OptimoSupreme/reactor/docs/images/layout-study-cpu-side.png

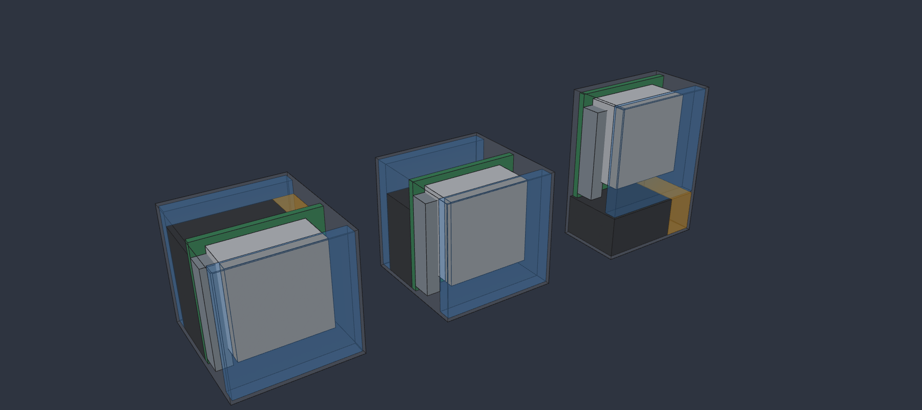
docs/images/layout-study-cpu-side.png
