OptimoSupreme/reactor/docs/images/layout-study-psu-side.png

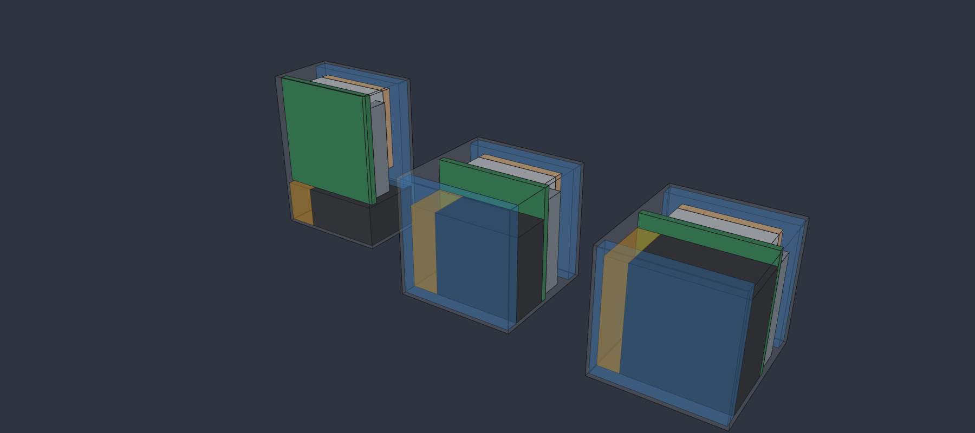
docs/images/layout-study-psu-side.png
