OptimoSupreme/reactor/docs/images/mk1-board-rear.png

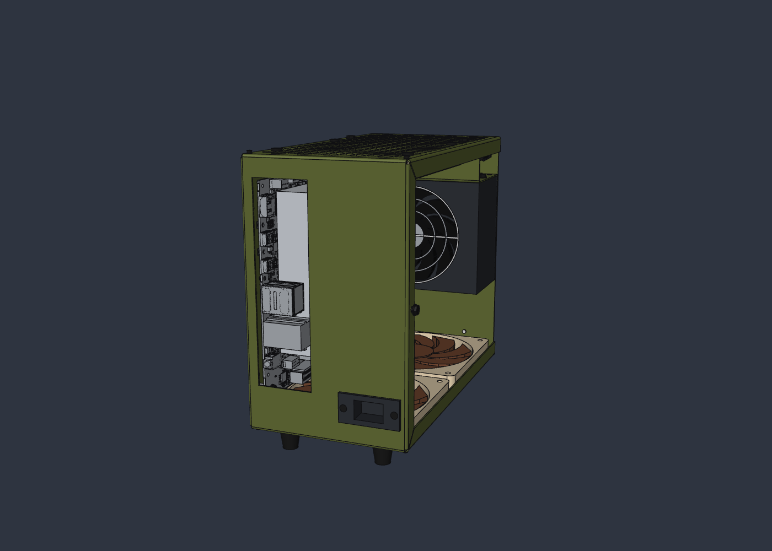
docs/images/mk1-board-rear.png
