OptimoSupreme/reactor/docs/images/mk1-foot.png

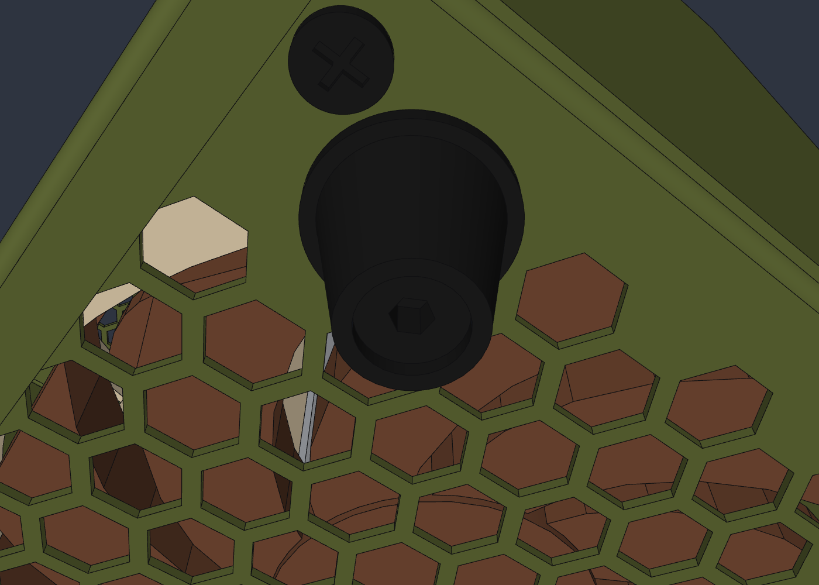
docs/images/mk1-foot.png
