OptimoSupreme/reactor/docs/images/mk1-open-board-side.png

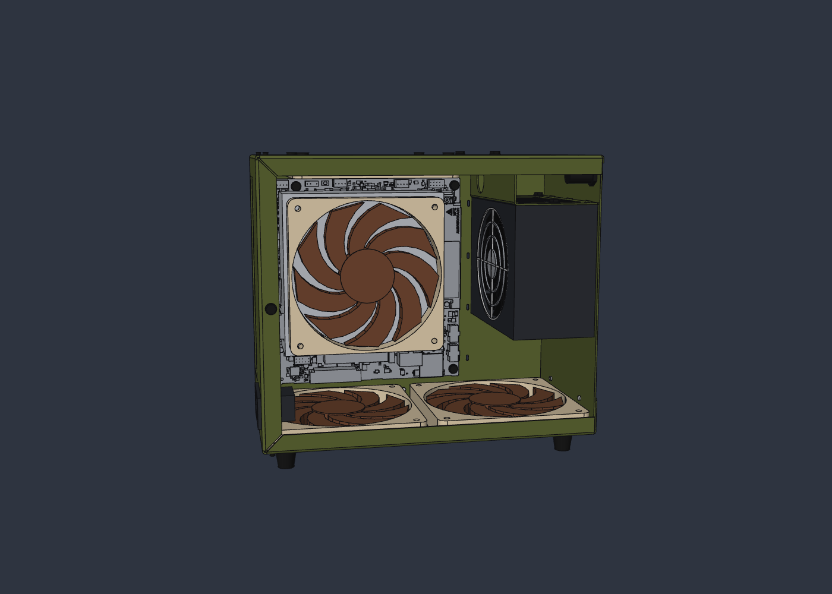
docs/images/mk1-open-board-side.png
