OptimoSupreme/reactor/docs/images/mk1-open-front.png

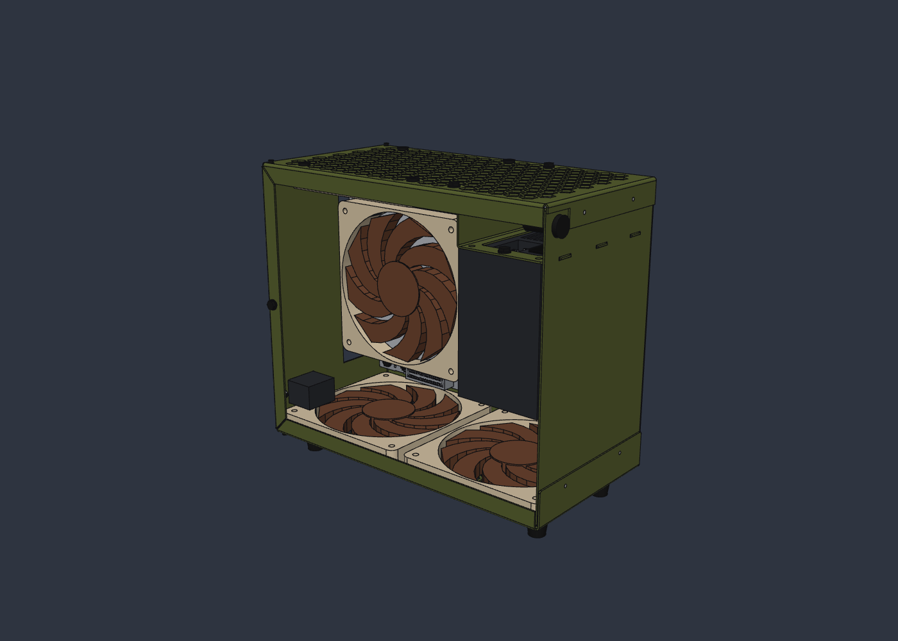
docs/images/mk1-open-front.png
