OptimoSupreme/reactor/docs/images/mk1-psu-mount.png

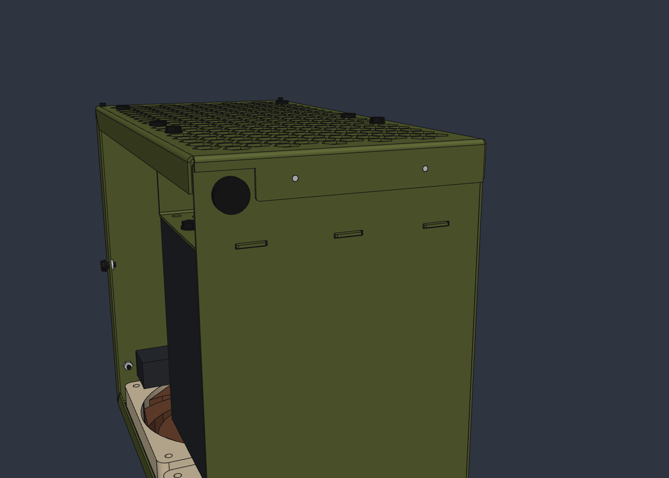
docs/images/mk1-psu-mount.png
