OptimoSupreme/reactor/docs/images/mk1-rear-corner.png

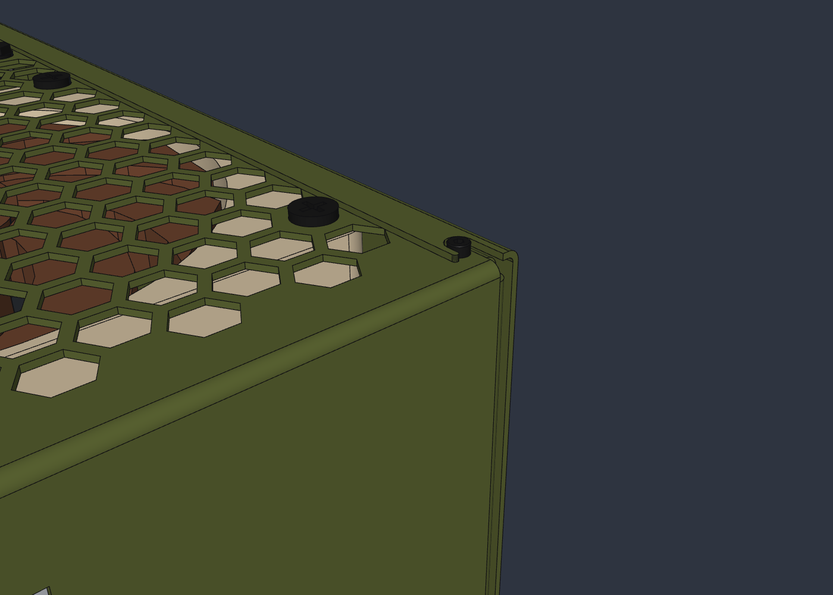
docs/images/mk1-rear-corner.png
