OptimoSupreme/reactor/docs/images/mk1-shelf-alone.png

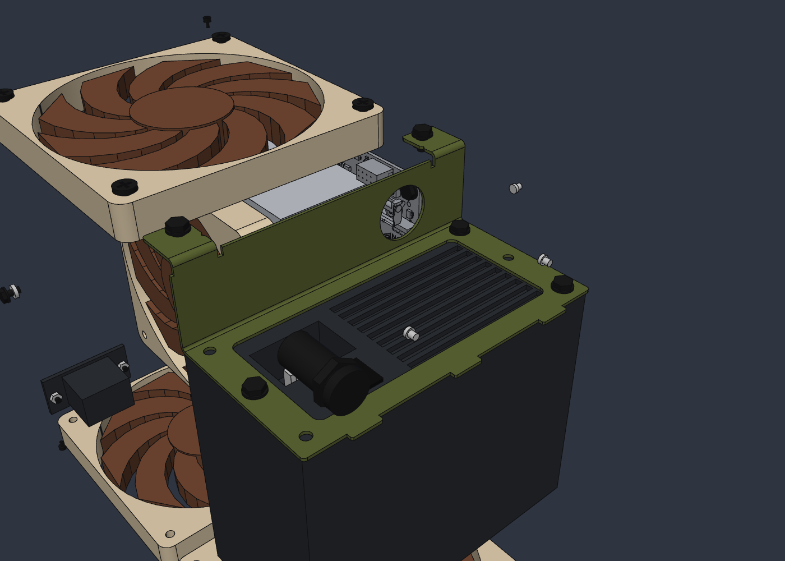
docs/images/mk1-shelf-alone.png
