OptimoSupreme/reactor/docs/images/mk1-shelf-tongues.png

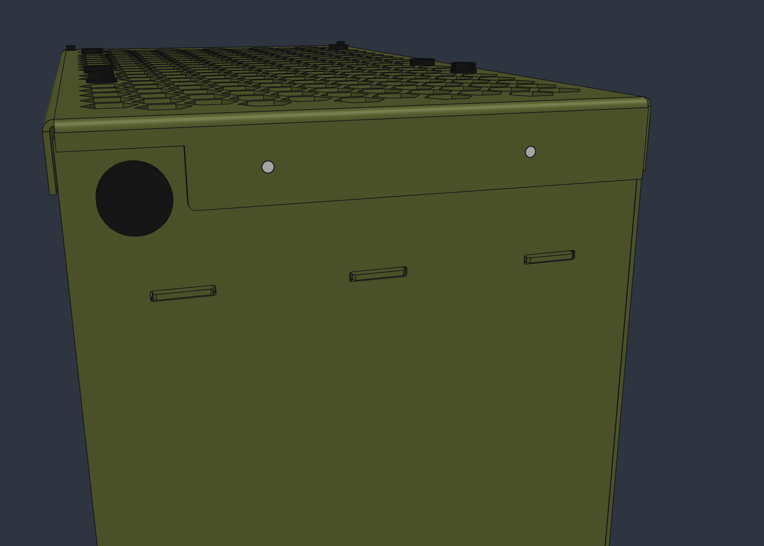
docs/images/mk1-shelf-tongues.png
