OptimoSupreme/reactor/docs/images/mk1-shelf-top.png

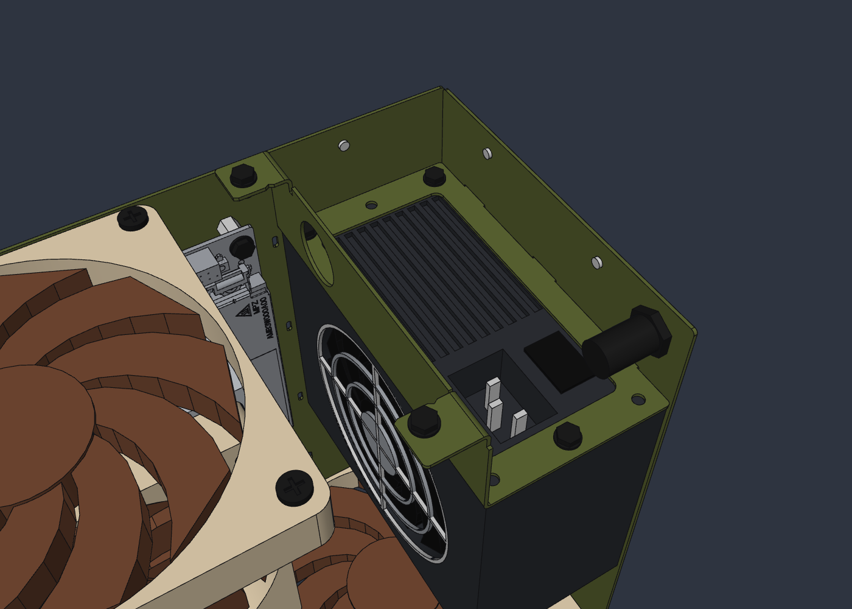
docs/images/mk1-shelf-top.png
