OptimoSupreme/reactor/docs/images/mk1-shell-screw-inside.png

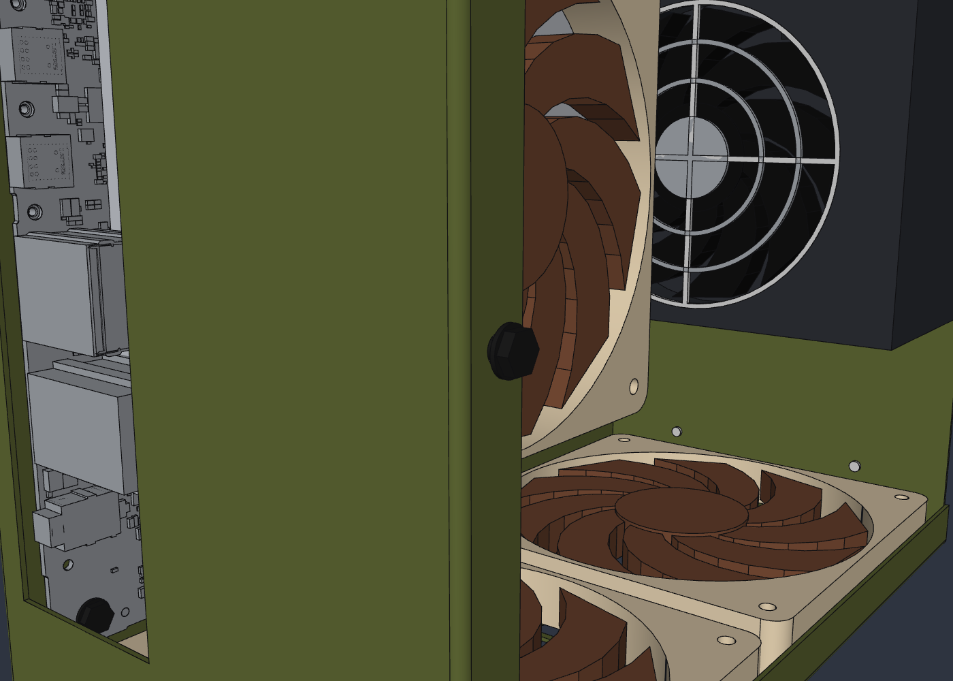
docs/images/mk1-shell-screw-inside.png
