OptimoSupreme/reactor/docs/images/mk1-switch-front.png

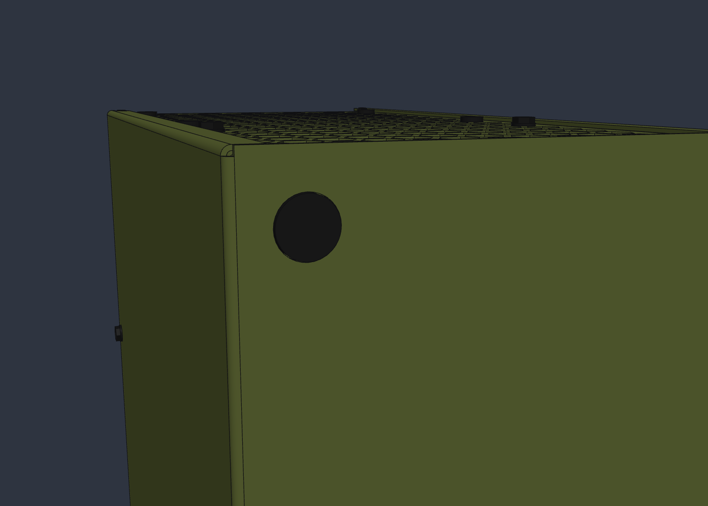
docs/images/mk1-switch-front.png
