OptimoSupreme/reactor/docs/images/mk1-switch-inside.png

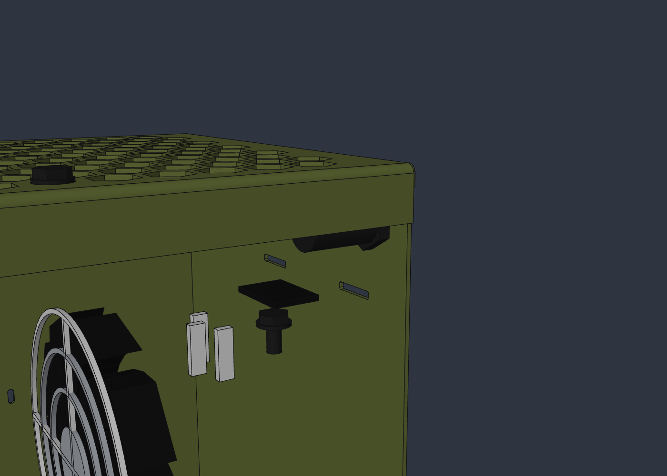
docs/images/mk1-switch-inside.png
