OptimoSupreme/reactor/docs/images/mk1-tie-slots.png

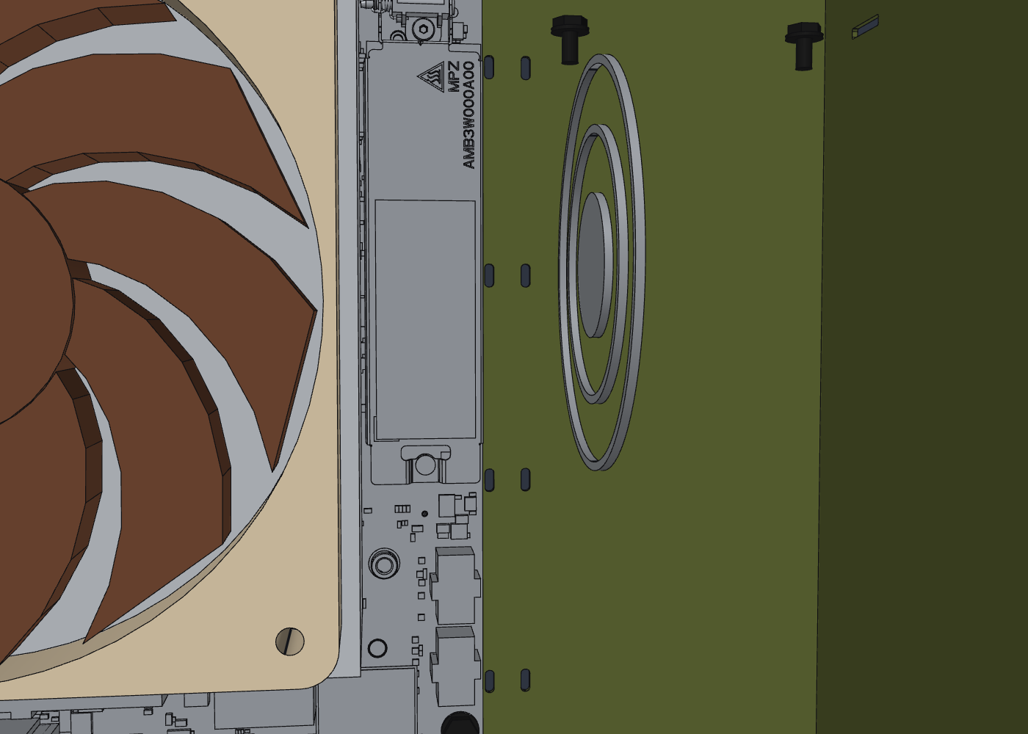
docs/images/mk1-tie-slots.png
