OptimoSupreme/reactor/docs/images/mk1-top-detail.png

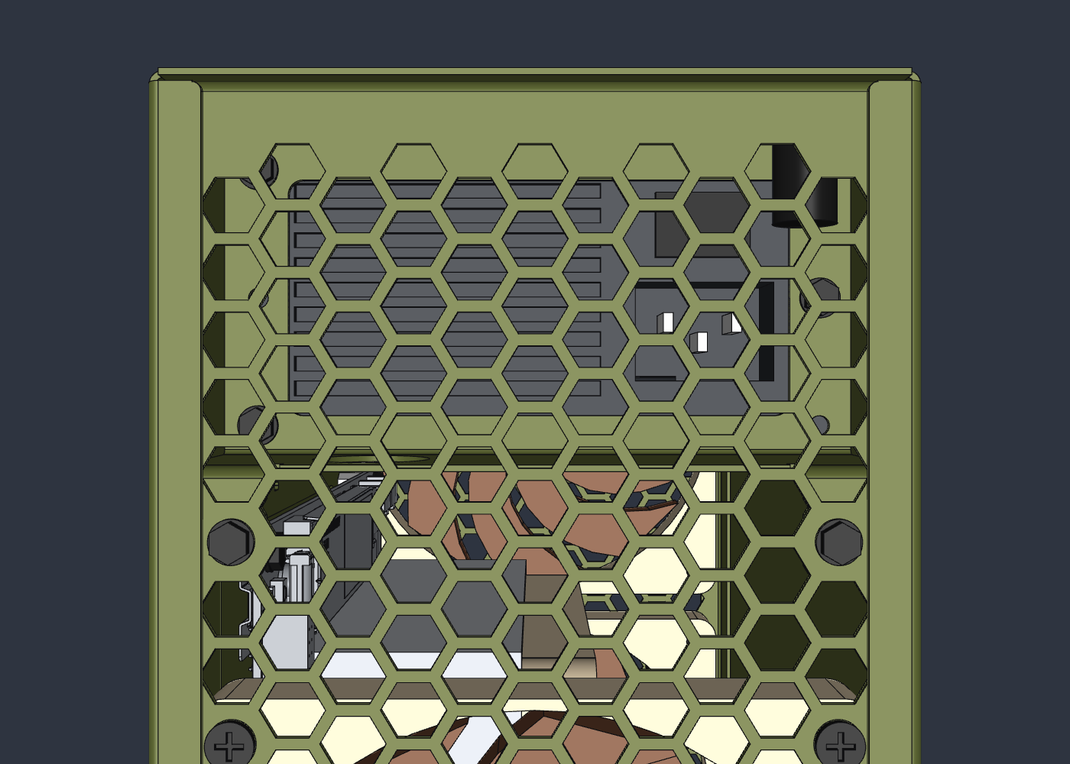
docs/images/mk1-top-detail.png
