OptimoSupreme/reactor/docs/images/mk1-top-plan.png

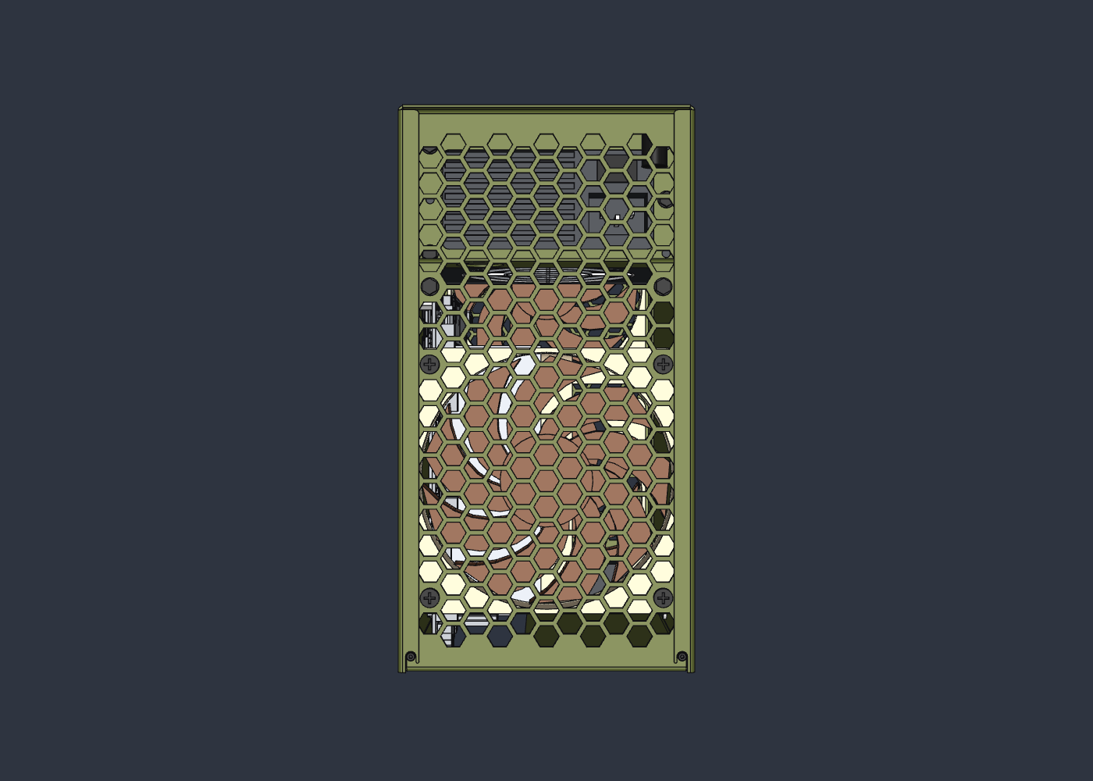
docs/images/mk1-top-plan.png
