OptimoSupreme/reactor/docs/images/mk1-top.png

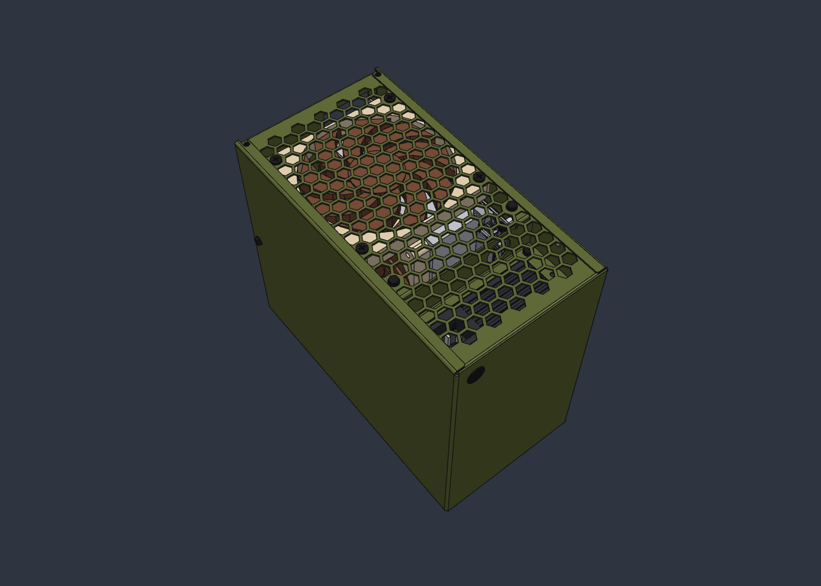
docs/images/mk1-top.png
