OptimoSupreme/reactor/docs/images/mk1-tray-side.png

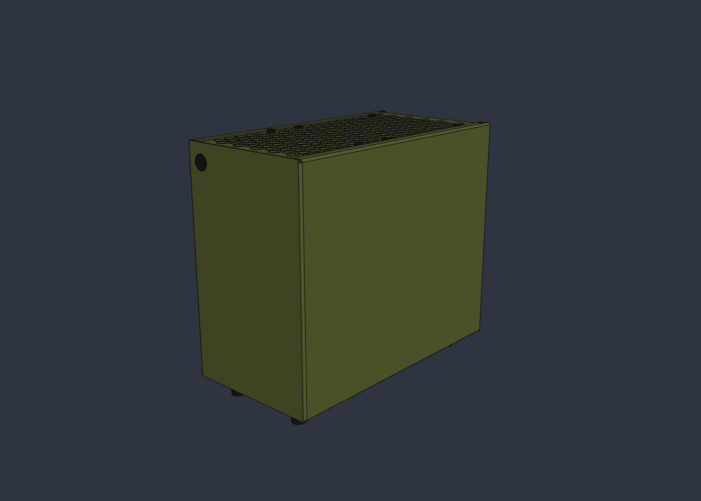
docs/images/mk1-tray-side.png
