OptimoSupreme/reactor/docs/images/mk1-under-corner.png

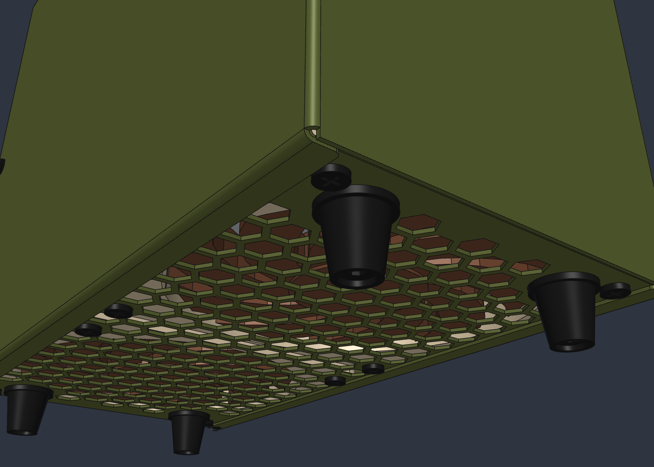
docs/images/mk1-under-corner.png
