OptimoSupreme/reactor/docs/images/mk1-under-plan.png

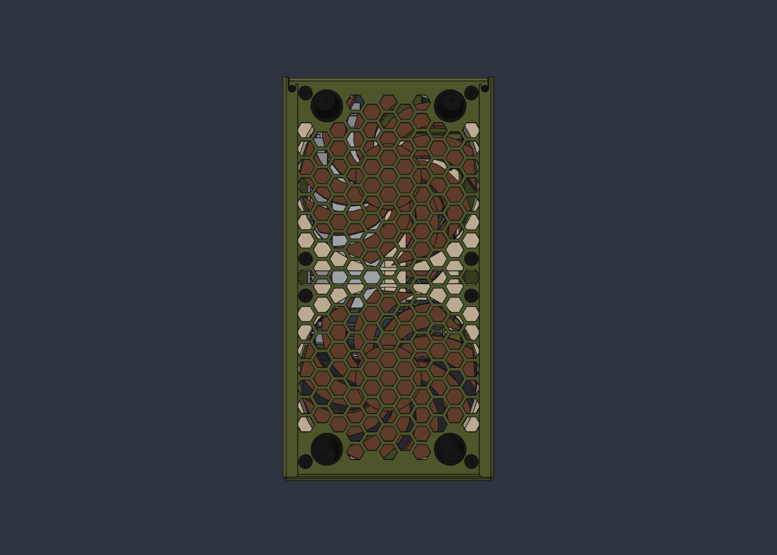
docs/images/mk1-under-plan.png
