OptimoSupreme/reactor/docs/images/mk1-under.png

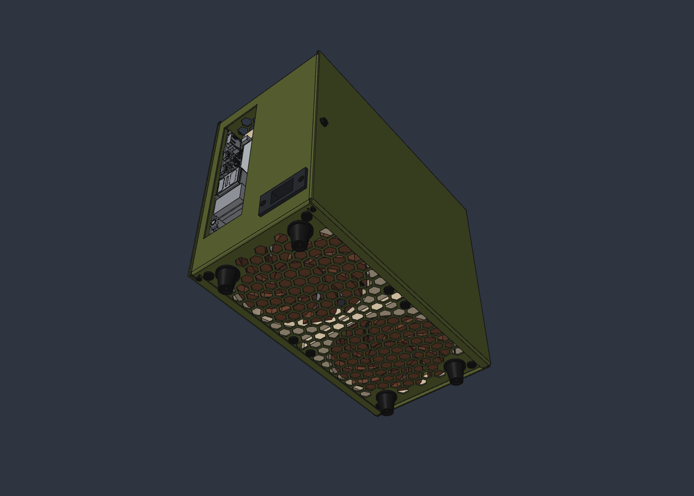
docs/images/mk1-under.png
