OptimoSupreme/reactor/mechanical/export/shell.step

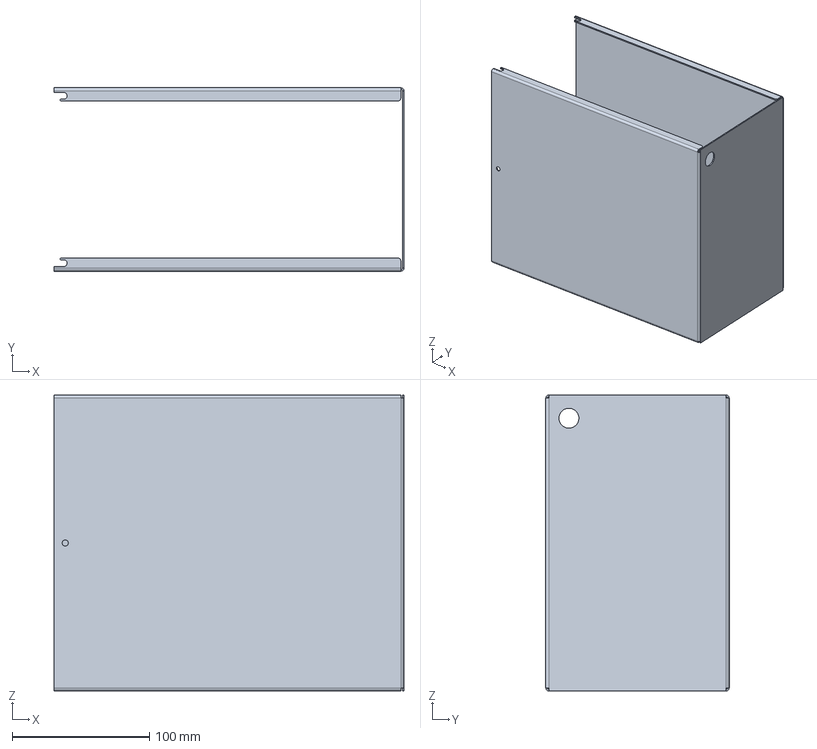
[picture p29: CAD file, 2026-11-13]
mechanical/export/shell.step
255.2 x 133.8 x 215.8 mm
