OptimoSupreme/reactor/mechanical/export/core.step

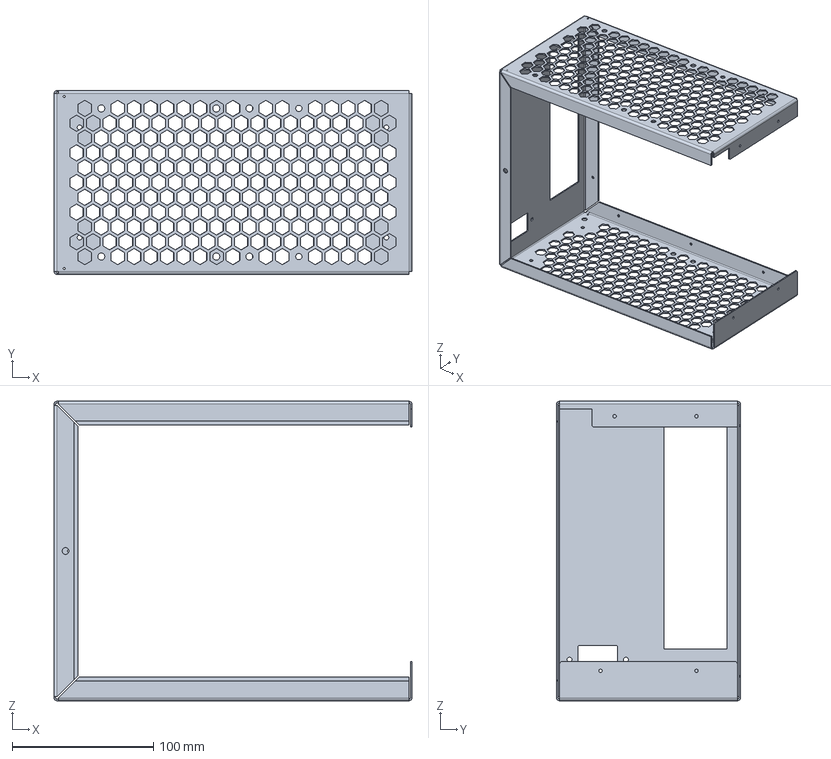
[picture p30: CAD file, 2026-11-13]
mechanical/export/core.step
253.7 x 130.4 x 212.4 mm
