OptimoSupreme/reactor/mechanical/export/shelf.step

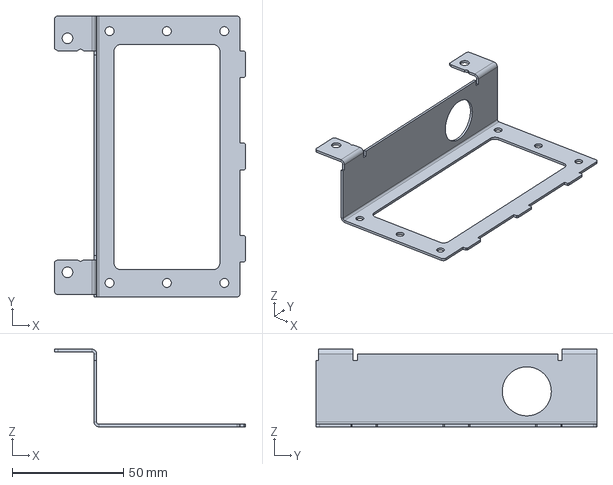
[picture p31: CAD file, 2026-11-13]
mechanical/export/shelf.step
85.7 x 126.1 x 34.9 mm
