OptimoSupreme/reactor/mechanical/export/bulkhead.step

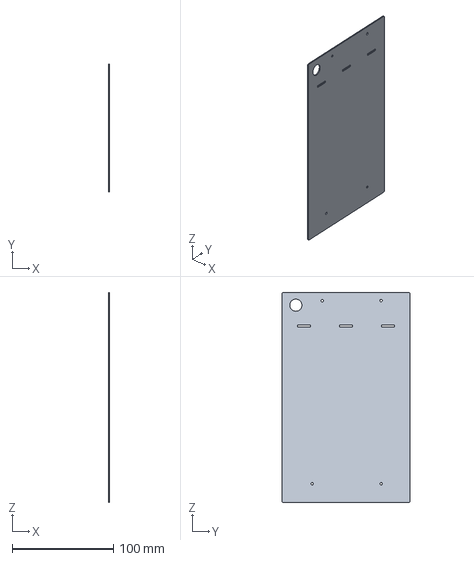
[picture p32: CAD file, 2026-11-13]
mechanical/export/bulkhead.step
1.20 x 126.1 x 207.0 mm
