OptimoSupreme/reactor/mechanical/export/foot.step

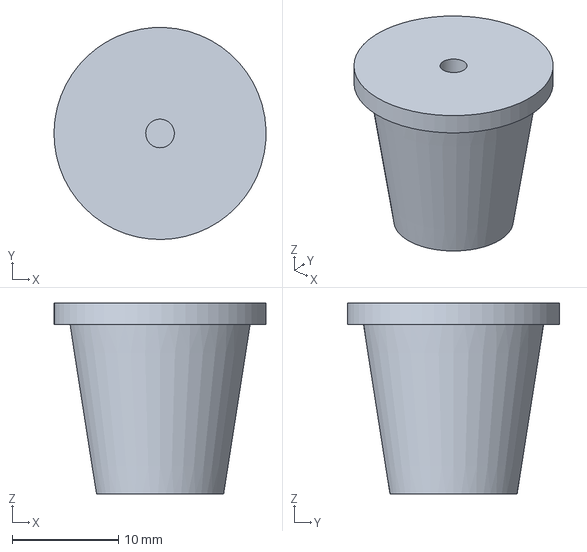
[picture p33: CAD file, 2026-11-13]
mechanical/export/foot.step
20.0 x 20.0 x 18.0 mm
