OptimoSupreme/reactor/mechanical/export/tray.step

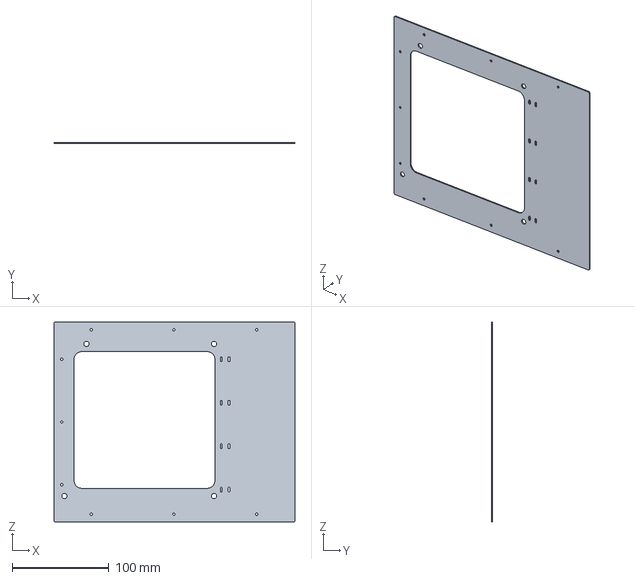
[picture p34: CAD file, 2026-11-12]
mechanical/export/tray.step
249.5 x 1.20 x 207.0 mm
