OptimoSupreme/reactor/(list of files, cad)

Other CAD files:
mechanical/export/bulkhead.dxf
mechanical/export/core.dxf
mechanical/export/shelf.dxf
mechanical/export/shell.dxf
mechanical/export/tray.dxf
