OptimoSupreme/reactor/(commit log)

2026-11-11 feat: add first mk i sheet metal model and airflow set-up
    Layout with an ATX supply behind the board and a 140 mm fan top and bottom, as three folded parts built by mechanical/mk1.py. The airflow set-up has only had a coarse stability check.
    [core-bends.csv, core.dxf, shell-bends.csv, shell.dxf, tray-bends.csv, tray.dxf]
2026-11-11 feat: rework mk i around an sfx supply in front of the board
    The ATX layout left no cable path round the board and starved the supply of air. This follows the KXRORS M02 instead: board on a tray against one side wall, SFX supply in front of it with its fan toward the board and its exhaust up into a baffled space under the top mesh, two slim 120 mm fans below and one above. sim/airflow.py still describes the old layout.
    [bracket-bends.csv, bracket.dxf, core-bends.csv, core.dxf, shell-bends.csv, shell.dxf, tray-bends.csv, tray.dxf]
2026-11-11 feat: fit mk i to the mini-itx rear panel and check it against the real board
    Cut the standard I/O aperture from ATX 2.03 figure 4 and drop the tray's rear flange, which sat in its keepout. Move the mains inlet low on the rear panel, lying flat. Add mk1.py --board, which builds the case round Framework's own model of the board and reports the fit: its holes land on the standoffs and its ports inside the aperture.
    [bracket.dxf, core.dxf, tray-bends.csv, tray.dxf]
2026-11-11 feat: carry the supply on a front bulkhead instead of the top mesh
    A flat bulkhead across the front, bolted to the front lips of the top and bottom panels, takes the supply's weight to the floor and holds up the top panel's front edge. The supply hangs under a shelf riveted to it, whose straight rear wall is the baffle and has a tab at each side for a screw through the top panel. The top mesh has no stud lands left. SolidCraft cannot model the wall's straight part level with its tabs, so it stops 2.4 short of the top panel.
    [bracket-bends.csv, bracket.dxf, bulkhead-bends.csv, bulkhead.dxf, core.dxf, shelf-bends.csv, shelf.dxf]
2026-11-11 feat: bring the airflow set-up over to the sfx layout
    The power supply is now an open box with a fan in its face and a loss for its insides, both assumed. FieldCraft accepts the set-up; no case has been solved. Retake the renders with Framework's board in the case.
2026-11-11 fix: centre the grommet hole between the slot above and the bend below
    It sat 0.5 mm under the relief slot beside the tab.
    [shelf.dxf]
2026-11-11 fix: end the shelf tabs at the next cell's corner
    They ran 0.9 mm past it, which left a sharp point beyond the corner cut-out.
    [shelf.dxf]
2026-11-12 feat: hold the shell with screw heads at the rear corners
    Slots in the shell's flanges run onto M2 cap-screw heads at three rear corners, so the shell cannot be peeled open, and a thumbscrew at the fourth holds it on. The flanges are narrowed to clear the fan screws.
    [core.dxf, shell.dxf]
2026-11-12 feat: add an assembly model and settle the fasteners
    The build now saves two designs: the sheet metal alone, for a shop, and an assembly with the bought-in parts, screws, nuts and rivets for looking at and checking clashes.
    Screws are 6-32 throughout, with matching pressed-in standoffs, nuts and studs, apart from the fan screws, the mains inlet's countersunk M3s and the M2 cap screws on the shell, one of which replaces the thumbscrew. The power button moves to the bulkhead with a 13 mm hole in the shell over its head, the tray gets an opening behind the board, and the shelf tabs are trimmed out of the cells beside them.
    [bulkhead.dxf, core.dxf, shelf-bends.csv, shelf.dxf, shell.dxf, tray.dxf]
2026-11-12 feat: stand the supply against the bulkhead
    The supply moves forward until it is 1.4 from the bulkhead, and the
    space that frees goes between it and the board, 13.1 where it was 8.
    The bottom fans stay 11 mesh pitches apart so every fan screw lands on
    a cell, which now sets the length: 0.4 shorter than before. The top
    fan moves one pitch toward the rear and the feet 1 mm inward, clear of
    the fan screws' heads.
    The designs are saved by SolidCraft 0.40.1, which 0.30.1 cannot open.
    [bulkhead.dxf, core-bends.csv, core.dxf, shelf-bends.csv, shelf.dxf, shell-bends.csv, shell.dxf, tray.dxf]
2026-11-12 fix: open the mesh cell beside each foot again
    Moving the feet inward had closed one more cell at each. The land
    round a foot is now 12, which leaves that cell 1.3 outside the foot's
    flange. The designs also had the shell hidden since the last commit;
    it is shown again, and the build now shows every sheet part itself.
    [core.dxf]
2026-11-12 feat: weld the core and make the mk i orderable
    The tray and bulkhead are spot welded to the core, the shelf comes out on
    three flush studs and two screws, the mains inlet has its real cut-out and
    the corners are rounded. mk1.py now builds the sheet metal alone for a shop
    and a second design with the board and every fastener for clash checks; that
    one is kept outside the repo, so the old assembly file goes.
    [bulkhead.dxf, bulkhead.step, core-bends.csv, core.dxf, core.step, shelf-bends.csv, shelf.dxf, shelf.step]
2026-11-12 docs: add the heat study and a before-ordering list
    airflow.py gains heat cases for the present board at full load and for a
    180 W chip. thermal.md has what they found and the noise estimate.
2026-11-12 feat: join with spotfast, add steel feet, open the switch hole
    The tray and bulkhead are fixed to the core with thirteen PEM SF-3-1.2
    fasteners in place of spot welds: flush on both faces, which the shell
    outside and the fans inside both need. The feet become a real part,
    printed in 316L and tapped, each turning onto a flush stud in the bottom
    panel, with a recess underneath for a pad. The shell's switch hole is 14.5
    for a 14 head. Drawings, exports and renders are regenerated.
    [bulkhead.dxf, bulkhead.step, core.dxf, core.step, foot.step, shell.dxf, shell.step, tray.dxf]
2026-11-12 docs: bring the readme and ordering notes up to date
    The supply is an SF450 or a Focus SGX-550 (2021), the mains lead has part
    numbers, and the heatsink and switch items are closed.
2026-11-12 fix: put the supply's inlet at the open side, earth pin to the fan
    With its fan toward the board, the SF450 and the Focus SGX-550 (2021) have
    the mains inlet and switch at the open side's end, the pins along the
    supply's width. The model's supply follows that and the shelf's grommet
    hole moves behind the inlet. drawings.py opens a fresh copy of the design,
    since opening the file itself could show an earlier build.
    [shelf.dxf, shelf.step]
2026-11-12 feat: screw the shelf on from the front and add cable tie slots
    Three low-head 6-32 screws through the bulkhead go into nuts in the
    shelf's front flange, in place of studs whose nuts no tool could reach.
    The shelf's top tabs fold toward the rear, so nothing stands over the
    supply's screws when the shelf is out. The tray gets four pairs of slots
    for cable ties between the board and the supply.
    [bulkhead.dxf, bulkhead.step, core.dxf, core.step, shelf-bends.csv, shelf.dxf, shelf.step, tray.dxf]
2026-11-12 docs: describe the shelf's screws, the tie slots and the feet's supplier
2026-11-12 feat: move the shelf's grommet hole to the tray side
    A plug angled at the shelf's rear wall would land on the shelf, 25 from
    the inlet. The mains lead's plug now points across the top of the supply
    to a hole over the gap between the board and the supply, where the lead
    runs down past the tie slots.
    [shelf.dxf, shelf.step]
2026-11-12 docs: settle the mains lead, the shelf screws and the gap
2026-11-13 feat: add a hex key socket to the feet
    A socket for a 3 mm key in the floor of each foot's pad recess, to
    tighten the foot on its stud. The pad goes on over it and keeps five
    sixths of its face.
    [foot.step]
2026-11-13 docs: note the feet's key socket
2026-11-13 feat: hold the shell with one case screw in its side
    A 6-32 screw through the open-side panel, at the rear and halfway up,
    goes into a nut pressed into the rear panel's lip, so the shell comes off
    with the case standing where it is. The fourth rear corner gets an M2 pin
    and a slot like the other three, in place of the M2 screw underneath.
    [core.dxf, core.step, shell.dxf, shell.step]
2026-11-13 docs: describe the shell's screw and four pins
2026-11-13 feat: hang the shelf's front on tongues in the bulkhead
    No ordinary screw's head fits in the 1.5 between the bulkhead and the
    shell, so the shelf's front has no screws: three tongues on its front edge
    sit in slots in the bulkhead, and the two screws through the top panel
    keep it from sliding back out. The front flange, its three nuts and the
    low-head screws go.
    [bulkhead.dxf, bulkhead.step, shelf-bends.csv, shelf.dxf, shelf.step]
2026-11-13 docs: describe the shelf's tongues and the one kind of screw
2026-11-13 feat: rivet the core by hand and draw to fabworks' bends
    The tray and bulkhead are joined to the core with thirteen 3/32 in flush
    solid rivets set at home, in place of SpotFast, which no prototyping shop
    found lists or fits. The parts use Fabworks' inside radius and K factor
    for 0.048 in steel, and the shelf's tab height follows the radius.
    [core-bends.csv, core.dxf, core.step, shelf-bends.csv, shelf.dxf, shelf.step, shell-bends.csv, shell.dxf]
